lucas-minaberry/robot-hexapode/docs/assets/images/apercu.jpg

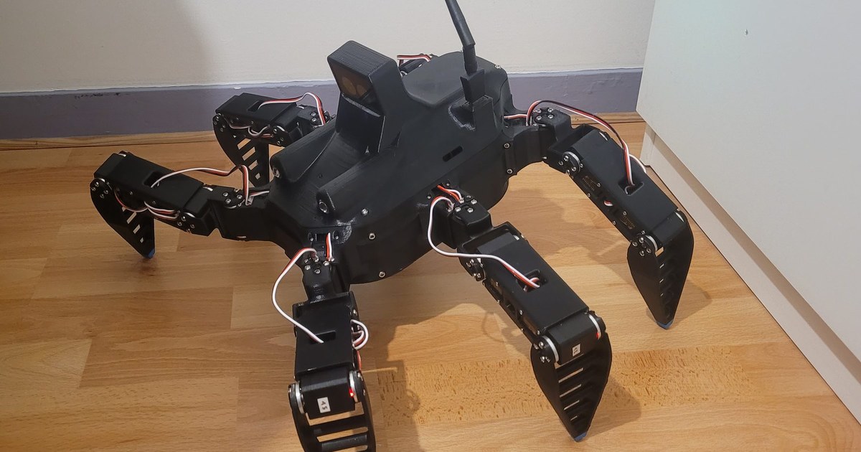
docs/assets/images/apercu.jpg
