lucas-minaberry/robot-hexapode/docs/assets/videos/antares_presentation.jpg

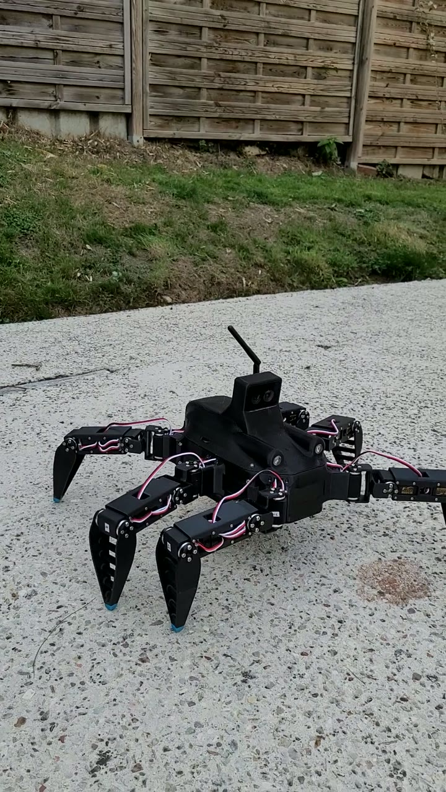
docs/assets/videos/antares_presentation.jpg
