lucas-minaberry/robot-hexapode/docs/assets/videos/digital_twin.jpg

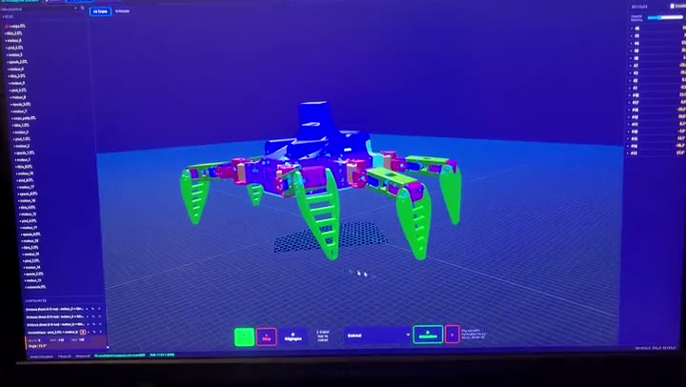
docs/assets/videos/digital_twin.jpg
