lucas-minaberry/robot-hexapode/docs/assets/videos/logiciel_animation_graphe.jpg

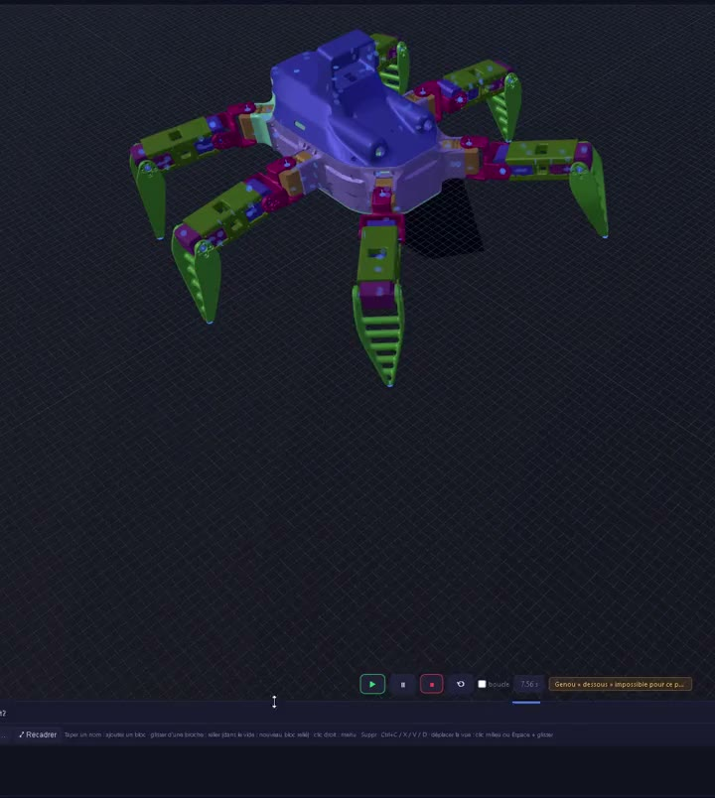
docs/assets/videos/logiciel_animation_graphe.jpg
