lucas-minaberry/robot-hexapode/docs/assets/videos/logiciel_animation_lecture.jpg

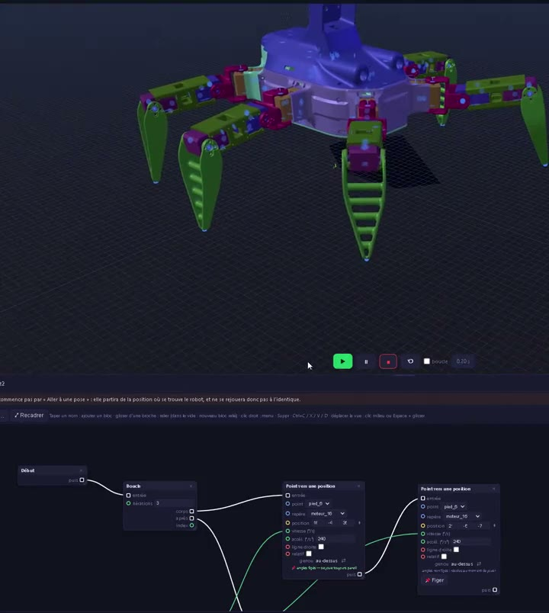
docs/assets/videos/logiciel_animation_lecture.jpg
