lucas-minaberry/robot-hexapode/docs/assets/videos/robot_assiette.jpg

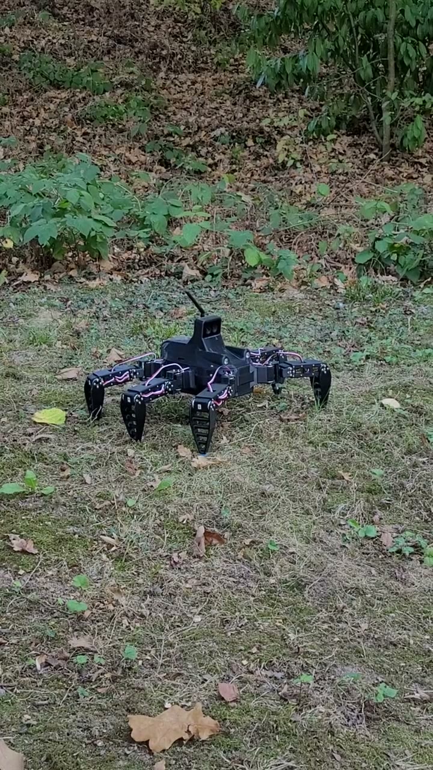
docs/assets/videos/robot_assiette.jpg
