lucas-minaberry/robot-hexapode/docs/assets/videos/robot_coucou.jpg

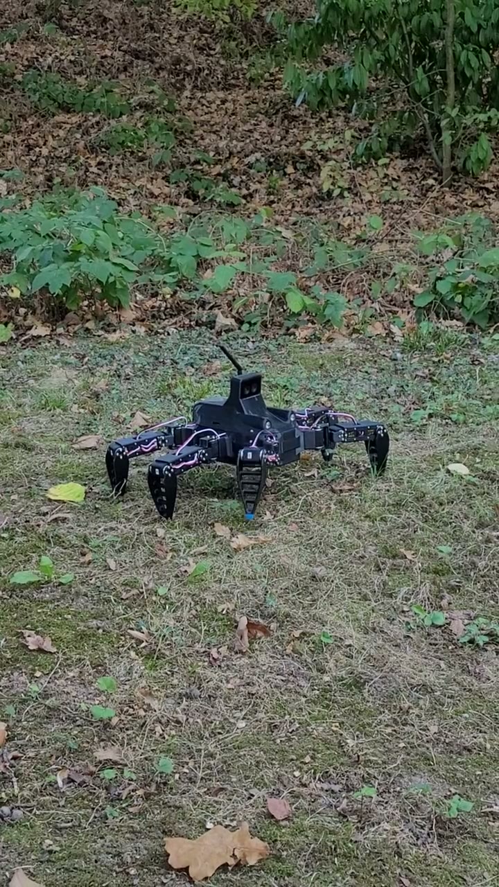
docs/assets/videos/robot_coucou.jpg
