lucas-minaberry/robot-hexapode/docs/assets/videos/robot_marche_terrasse.jpg

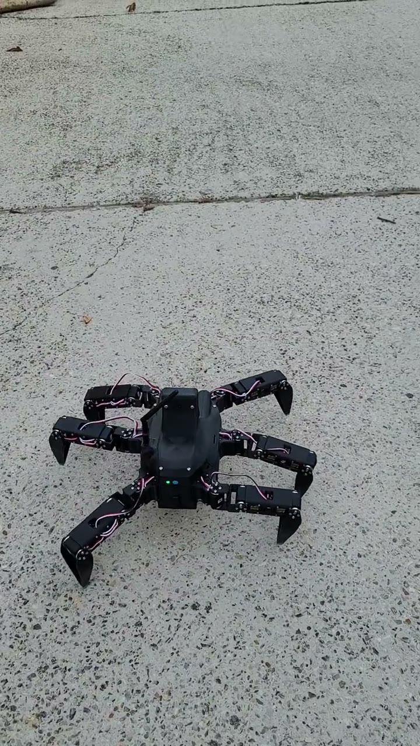
docs/assets/videos/robot_marche_terrasse.jpg
