lucas-minaberry/robot-hexapode/docs/assets/videos/robot_nuit.jpg

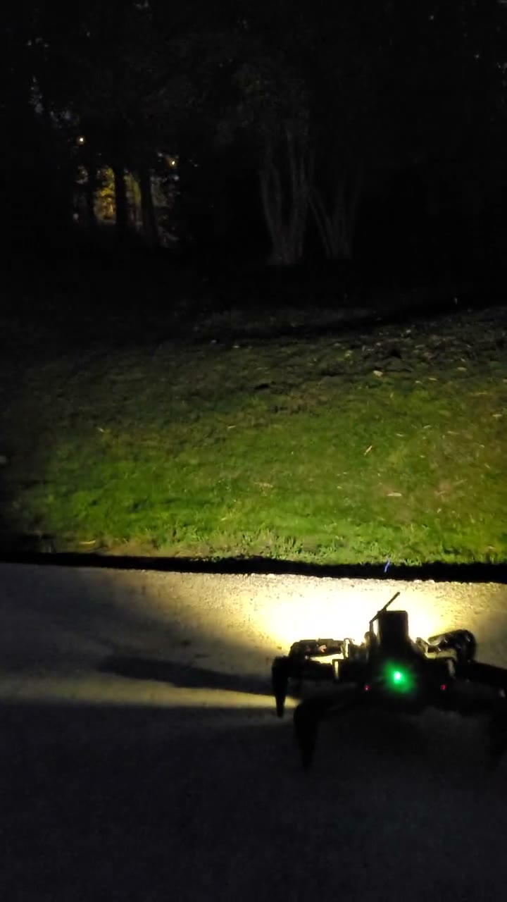
docs/assets/videos/robot_nuit.jpg
