lucas-minaberry/robot-hexapode/docs/assets/videos/robot_terrain_difficile.jpg

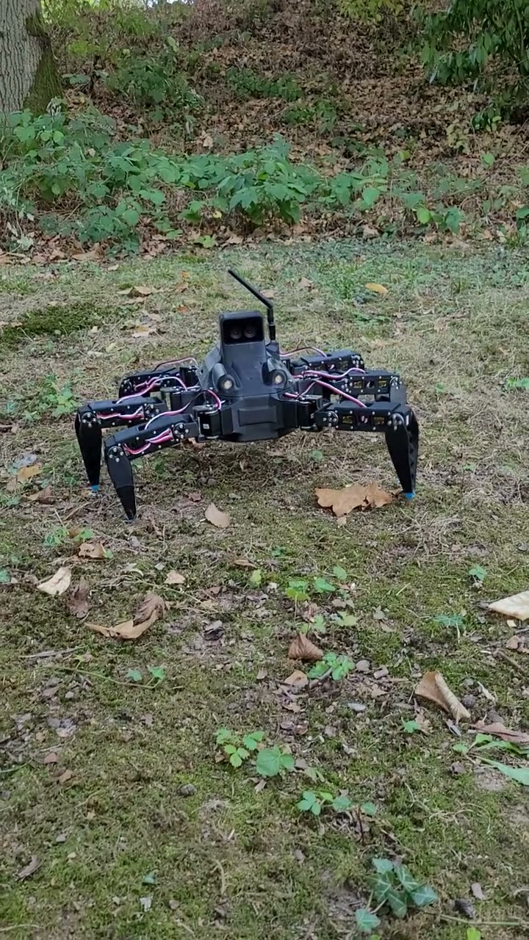
docs/assets/videos/robot_terrain_difficile.jpg
