lucas-minaberry/robot-hexapode/docs/assets/videos/vue_eclatee.jpg

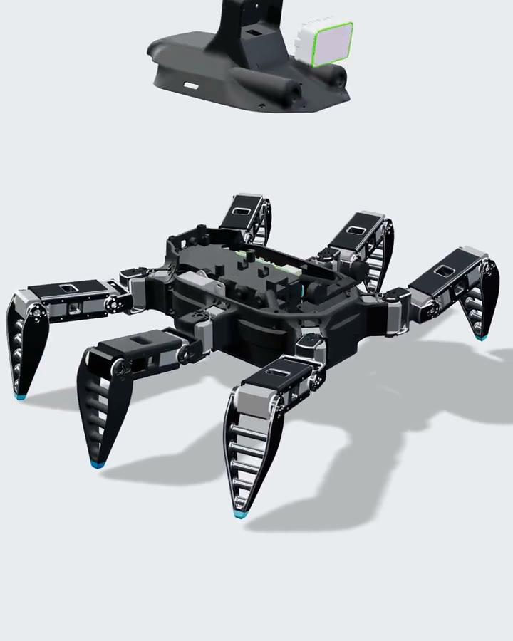
docs/assets/videos/vue_eclatee.jpg
