lucas-minaberry/robot-hexapode/docs/assets/videos/logiciel_assemblage.jpg

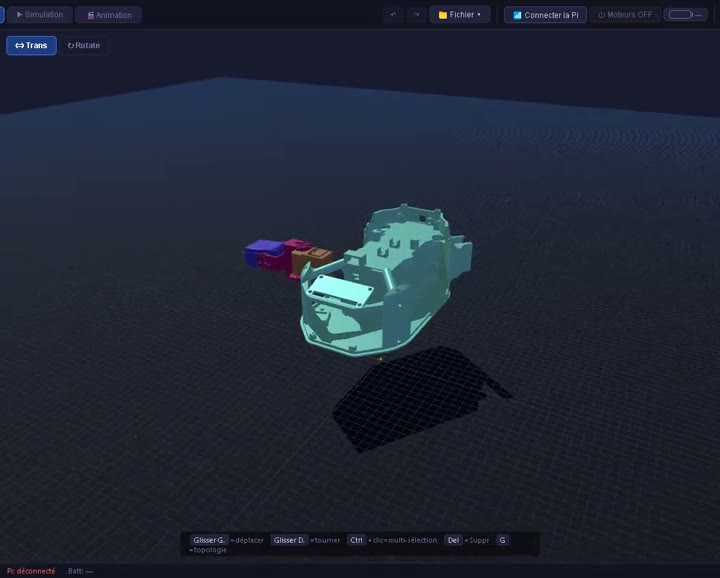
docs/assets/videos/logiciel_assemblage.jpg
