lucas-minaberry/robot-hexapode/docs/assets/videos/logiciel_patte_construction.jpg

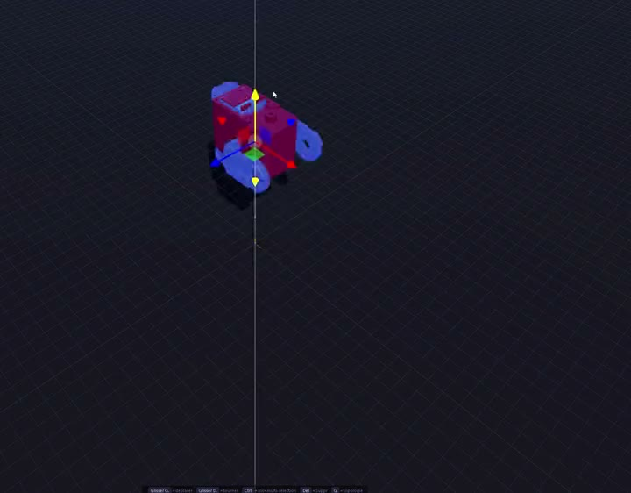
docs/assets/videos/logiciel_patte_construction.jpg
