lucas-minaberry/robot-hexapode/docs/assets/videos/montage_accelere.jpg

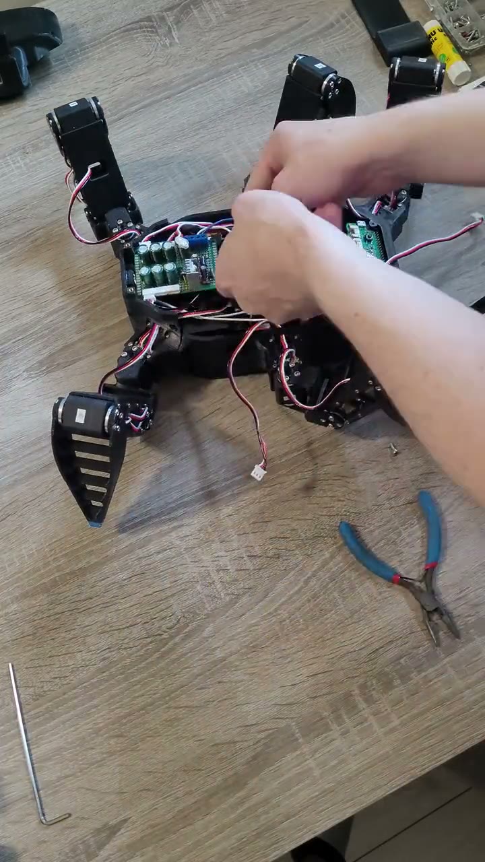
docs/assets/videos/montage_accelere.jpg
