lucas-minaberry/robot-hexapode/docs/assets/videos/logiciel_patte_resultat.jpg

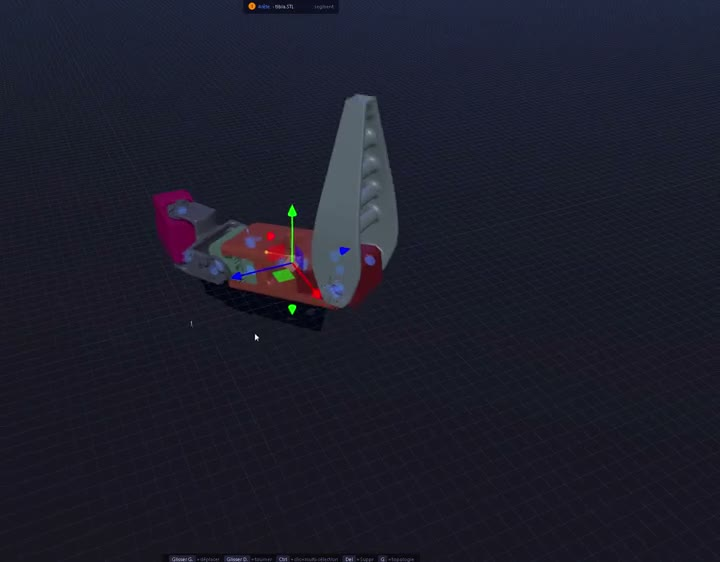
docs/assets/videos/logiciel_patte_resultat.jpg
