lucas-minaberry/robot-hexapode/docs/annexes/schema_electrique.pdf

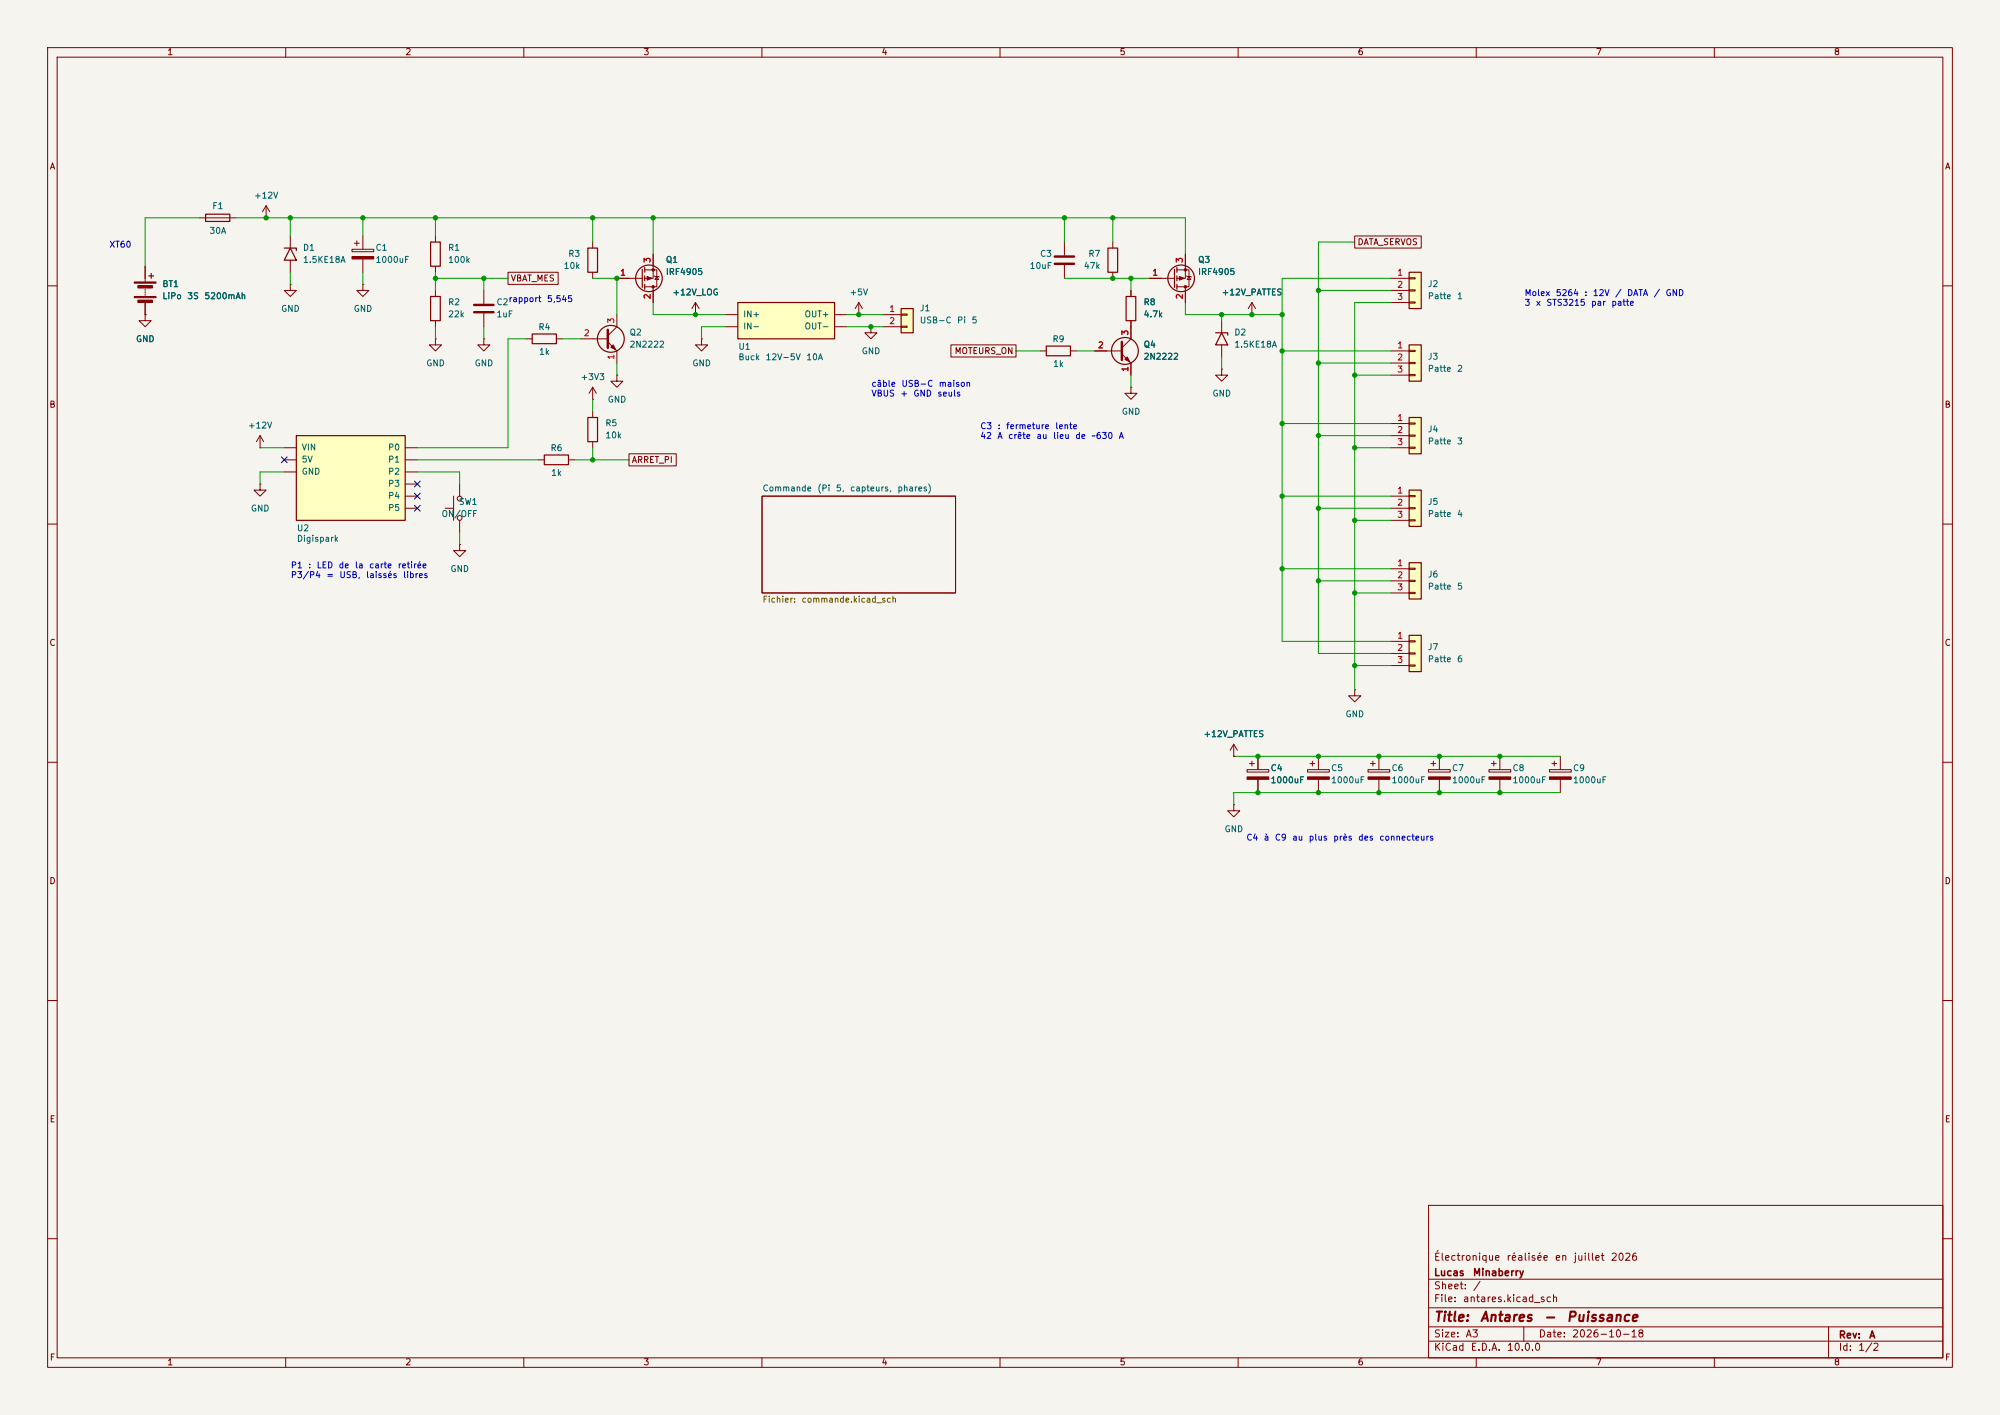
[picture p28: page 1]

Commande (Pi 5, capteurs, phares)

Électronique réalisée en juillet 2026

Size: A3 | Rev: A | F Date: 2026-10-18 KiCad E.D.A. 10.0.0

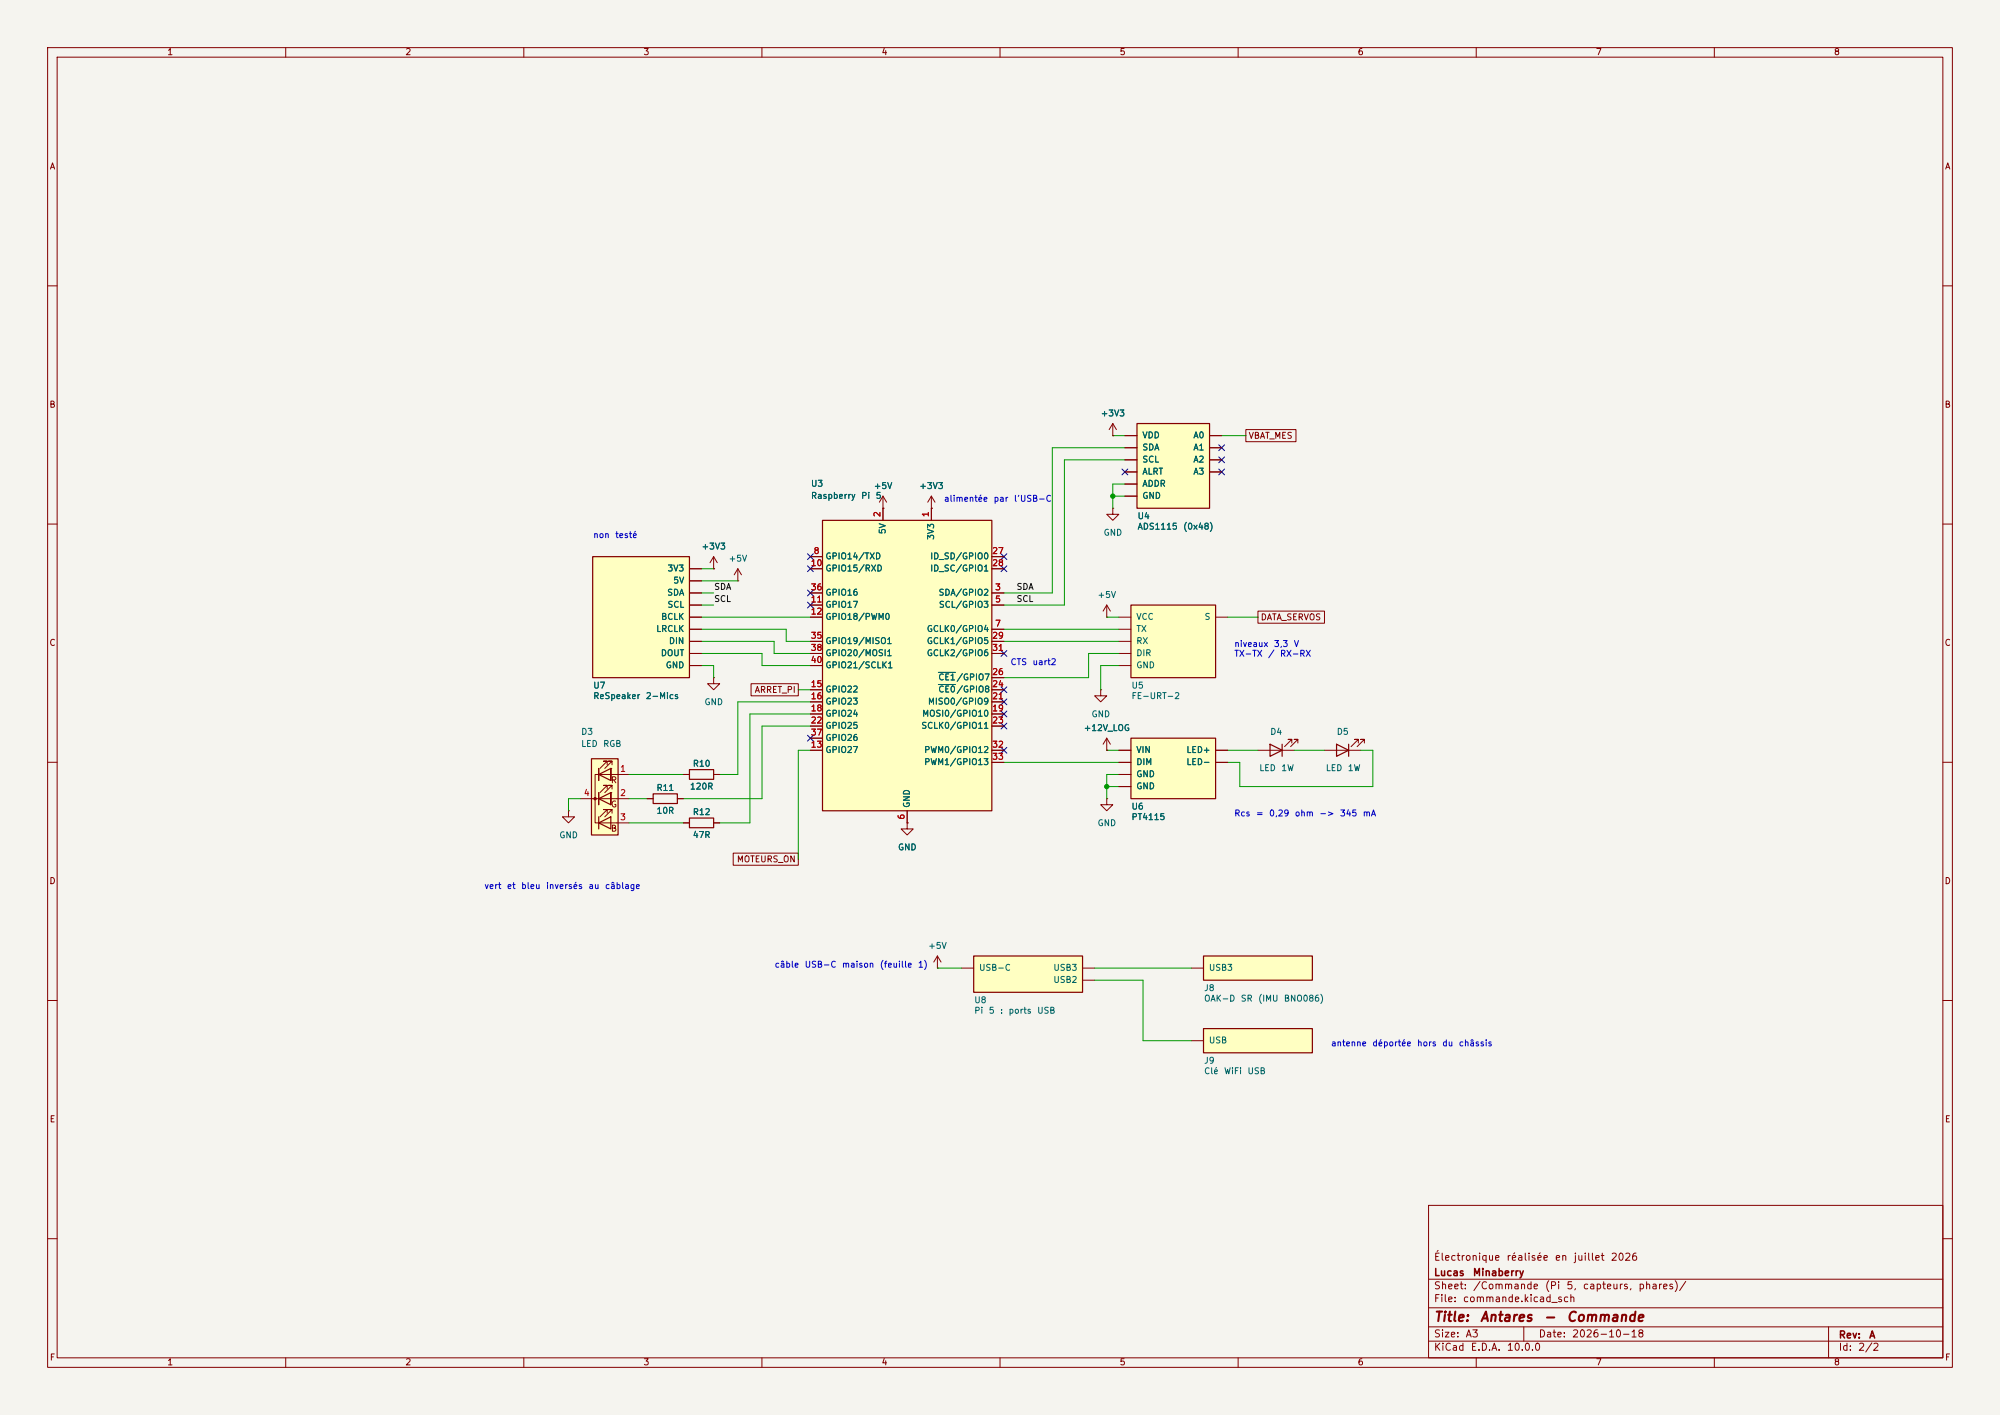
[picture p29: page 2]

ADS1115 (0x48) VDD
SDA SCL ALRT ADDR

VDD

niveaux 3,3 V

antenne déportée hors du châssis Rcs = 0,29 ohm -> 345 mA

vert et bleu inversés au câblage

câble USB-C maison (feuille 1)

Électronique réalisée en juillet 2026

Lucas Minaberry
Sheet: /Commande (Pi 5, capteurs, phares)/
File: commande.kicad_sch
Title: Antares - Commande

Size: A3 | Rev: A | F Date: 2026-10-18 KiCad E.D.A. 10.0.0
