lucas-minaberry/robot-hexapode/electronique/antares.kicad_sch

## KiCad design electronique/antares.kicad_sch (2026-10-18)

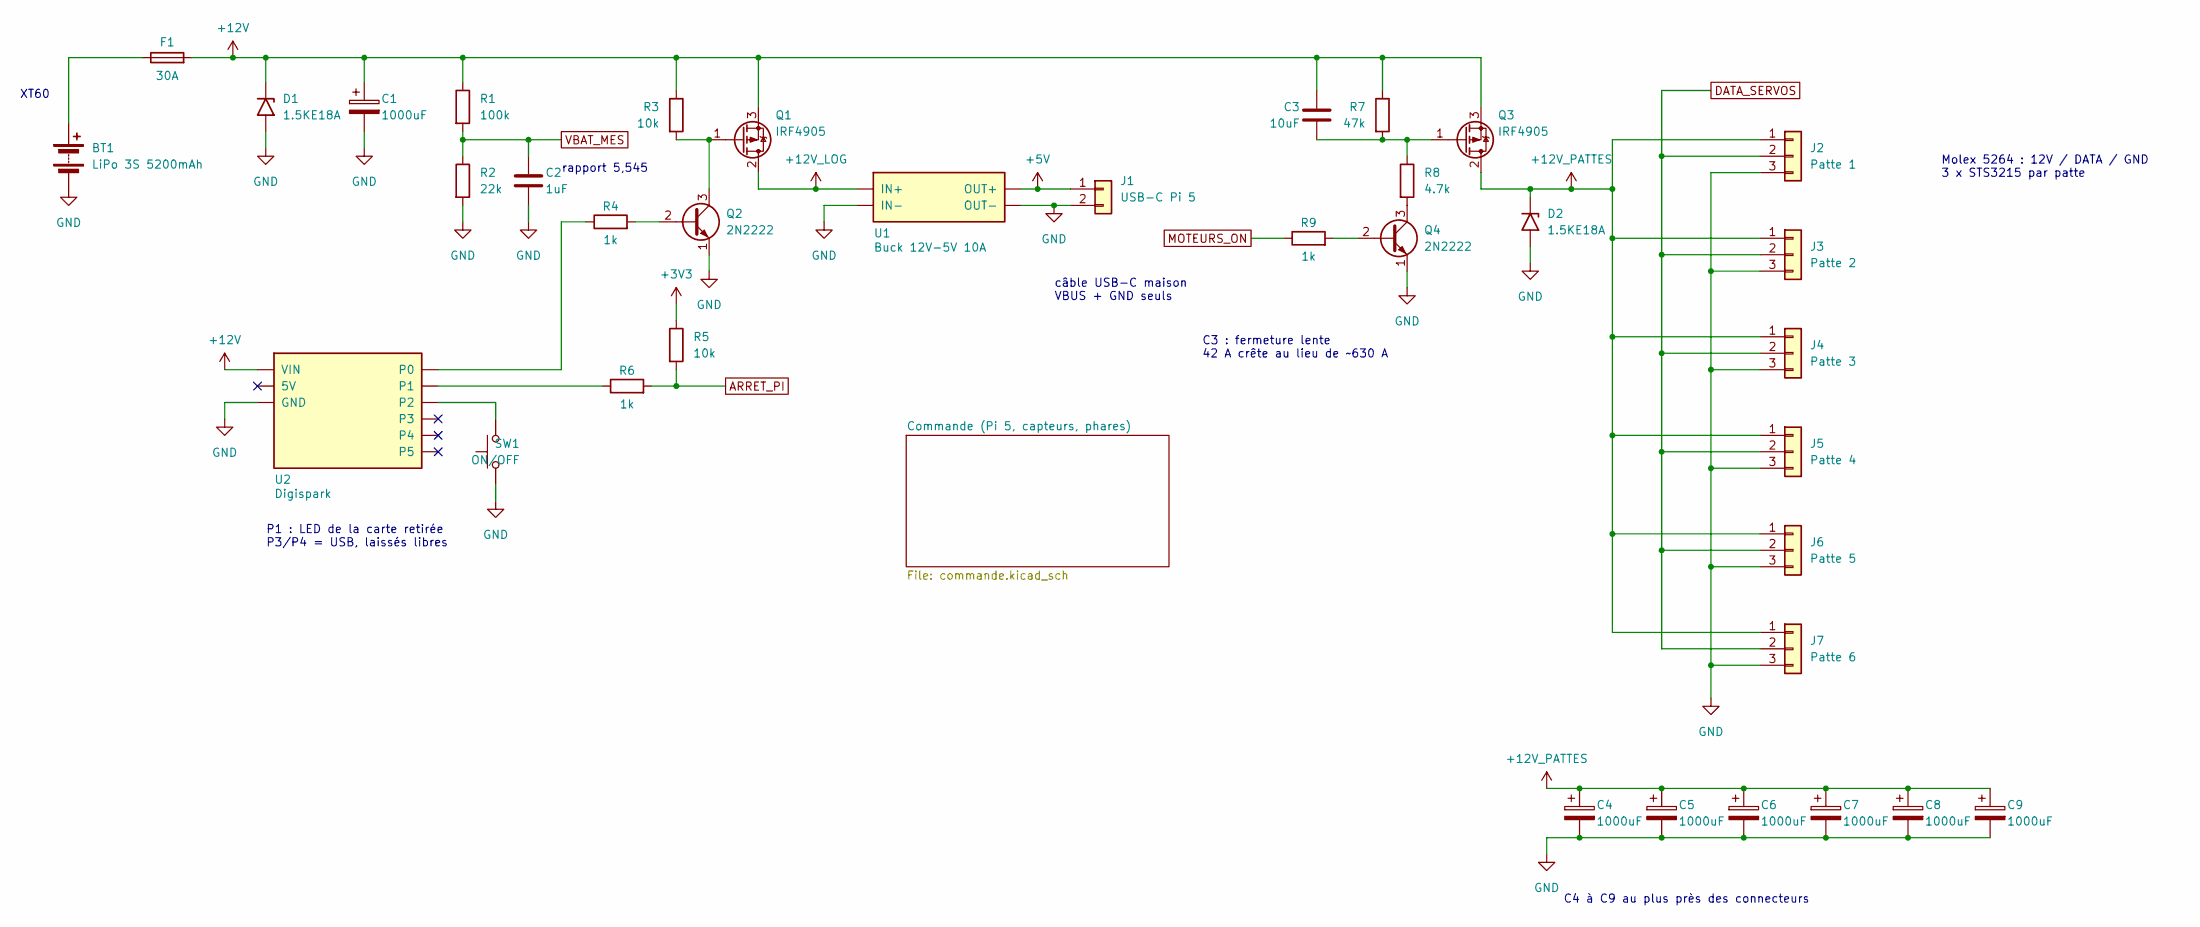
[picture p30: schematic antares.kicad_sch]

Parts:
BT1: LiPo 3S 5200mAh
C1, C4, C5, C6, C7, C8, C9: 1000uF
C2: 1uF
C3: 10uF
D1, D2: 1.5KE18A; D_DO-201AE_P15.24mm_Horizontal
F1: 30A
J1: USB-C Pi 5
J2: Patte 1
J3: Patte 2
J4: Patte 3
J5: Patte 4
J6: Patte 5
J7: Patte 6
Q1, Q3: IRF4905; TO-220-3_Vertical
Q2, Q4: 2N2222; TO-92_Inline
R1: 100k
R2: 22k
R3, R5: 10k
R4, R6, R9: 1k
R7: 47k
R8: 4.7k
SW1: ON/OFF
U1: Buck 12V-5V 10A
U2: Digispark

Connections:
+3V3: R5.1
+5V: J1.1, U1.3 (OUT+)
+12V: C1.1, C3.1, D1.1 (A1), F1.2, Q1.3 (S), Q3.3 (S), R1.1, R3.1, R7.1, U2.1 (VIN)
+12V_LOG: Q1.2 (D), U1.1 (IN+)
+12V_PATTES: C4.1, C5.1, C6.1, C7.1, C8.1, C9.1, D2.1 (A1), J2.1, J3.1, J4.1, J5.1, J6.1, J7.1, Q3.2 (D)
ARRET_PI: R5.2, R6.2
DATA_SERVOS: J2.2, J3.2, J4.2, J5.2, J6.2, J7.2
GND: BT1.2 (-), C1.2, C2.2, C4.2, C5.2, C6.2, C7.2, C8.2, C9.2, D1.2 (A2), D2.2 (A2), J1.2, J2.3, J3.3, J4.3, J5.3, J6.3, J7.3, Q2.1 (E), Q4.1 (E), R2.2, SW1.1, U1.2 (IN-), U1.4 (OUT-), U2.3 (GND)
MOTEURS_ON: R9.1
unnamed: BT1.1 (+), F1.1
unnamed: C3.2, Q3.1 (G), R7.2, R8.1
unnamed: Q1.1 (G), Q2.3 (C), R3.2
unnamed: Q2.2 (B), R4.2
unnamed: Q4.2 (B), R9.2
unnamed: Q4.3 (C), R8.2
unnamed: R4.1, U2.4 (P0)
unnamed: R6.1, U2.5 (P1)
unnamed: SW1.2, U2.6 (P2)
VBAT_MES: C2.1, R1.2, R2.1

Notes on the sheet:
Molex 5264 : 12V / DATA / GND 3 x STS3215 par patte
XT60
câble USB-C maison VBUS + GND seuls
C4 à C9 au plus près des connecteurs
rapport 5,545
C3 : fermeture lente 42 A crête au lieu de ~630 A
P1 : LED de la carte retirée P3/P4 = USB, laissés libres
