lucas-minaberry/robot-hexapode/electronique/commande.kicad_sch

## KiCad design electronique/commande.kicad_sch (2026-10-18)

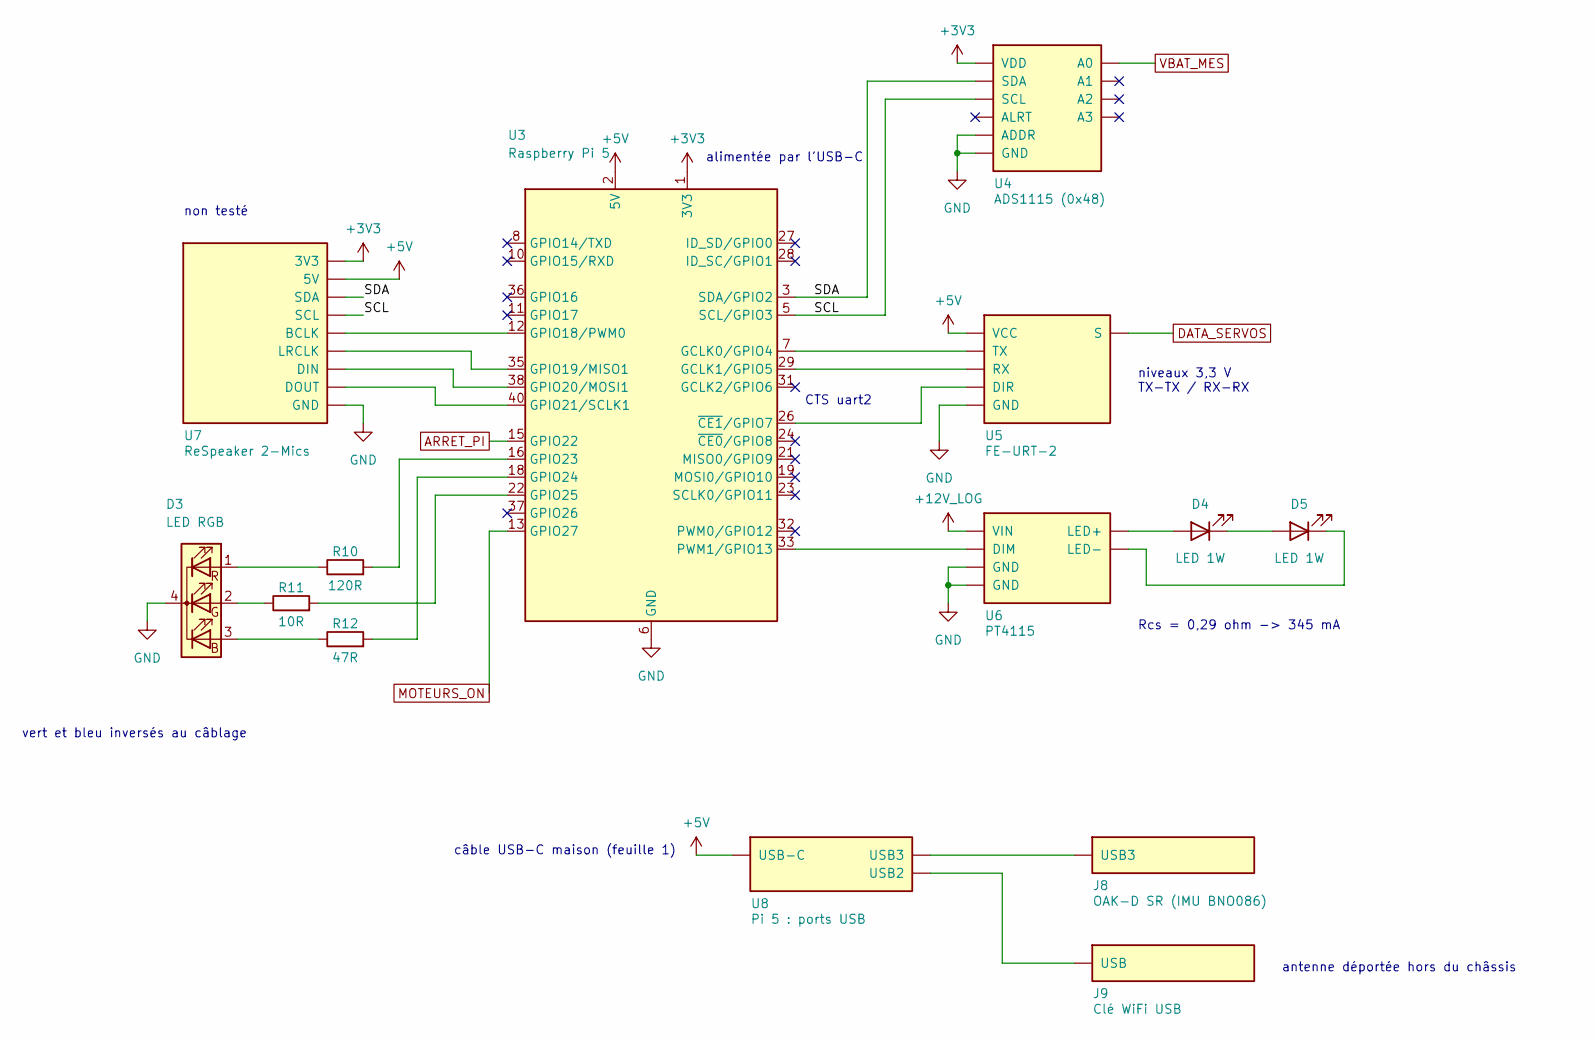
[picture p31: schematic commande.kicad_sch]

Parts:
D3: LED RGB
D4, D5: LED 1W
J8: OAK-D SR (IMU BNO086)
J9: Clé WiFi USB
R10: 120R
R11: 10R
R12: 47R
U3: Raspberry Pi 5
U4: ADS1115 (0x48)
U5: FE-URT-2
U6: PT4115
U7: ReSpeaker 2-Mics
U8: Pi 5 : ports USB

Connections:
+3V3: U3.1 (3V3), U3.17 (3V3), U4.1 (VDD), U7.1 (3V3)
+5V: U3.2 (5V), U3.4 (5V), U5.1 (VCC), U7.2 (5V), U8.1 (USB-C)
+12V_LOG: U6.1 (VIN)
ARRET_PI: U3.15 (GPIO22)
DATA_SERVOS: U5.6 (S)
GND: D3.4 (K), U3.6 (GND), U3.9 (GND), U3.14 (GND), U3.20 (GND), U3.25 (GND), U3.30 (GND), U3.34 (GND), U3.39 (GND), U4.5 (ADDR), U4.6 (GND), U5.5 (GND), U6.3 (GND), U6.4 (GND), U7.9 (GND)
MOTEURS_ON: U3.13 (GPIO27)
unnamed: D3.1 (RA), R10.1
unnamed: D3.2 (GA), R11.1
unnamed: D3.3 (BA), R12.1
unnamed: D4.1 (K), D5.2 (A)
unnamed: D4.2 (A), U6.5 (LED+)
unnamed: D5.1 (K), U6.6 (LED-)
unnamed: J8.1, U8.2 (USB3)
unnamed: J9.1, U8.3 (USB2)
unnamed: R10.2, U3.16 (GPIO23)
unnamed: R11.2, U3.22 (GPIO25)
unnamed: R12.2, U3.18 (GPIO24)
unnamed: U3.7 (GCLK0/GPIO4), U5.2 (TX)
unnamed: U3.12 (GPIO18/PWM0), U7.5 (BCLK)
unnamed: U3.26 (~CE1/GPIO7), U5.4 (DIR)
unnamed: U3.29 (GCLK1/GPIO5), U5.3 (RX)
unnamed: U3.33 (PWM1/GPIO13), U6.2 (DIM)
unnamed: U3.35 (GPIO19/MISO1), U7.6 (LRCLK)
unnamed: U3.38 (GPIO20/MOSI1), U7.7 (DIN)
unnamed: U3.40 (GPIO21/SCLK1), U7.8 (DOUT)
SCL: U3.5 (SCL/GPIO3), U4.3 (SCL), U7.4 (SCL)
SDA: U3.3 (SDA/GPIO2), U4.2 (SDA), U7.3 (SDA)
VBAT_MES: U4.7 (A0)

Notes on the sheet:
non testé
câble USB-C maison (feuille 1)
alimentée par l'USB-C
niveaux 3,3 V TX-TX / RX-RX
vert et bleu inversés au câblage
CTS uart2
Rcs = 0,29 ohm -> 345 mA
antenne déportée hors du châssis
